akosblack/rs485rfid/README.md

# RS485-re alapuló RFID-s kártyaolvasó rendszer

Az Önálló laboratórium című tárgy keretein belül témának ezt válaszottam, mely során megismerkedtem az RS485-öt felépítő áramköri elemekkel, működésükkel. Arduino segítségével áramkört terveztem, annak működését teszteltem is. A projekt működéséhez szükséges két kódot ide feltöltve elhelyeztem.
A dokumentációhoz szükséges latex és forrásfájlait is megtalálható ezen repoban.

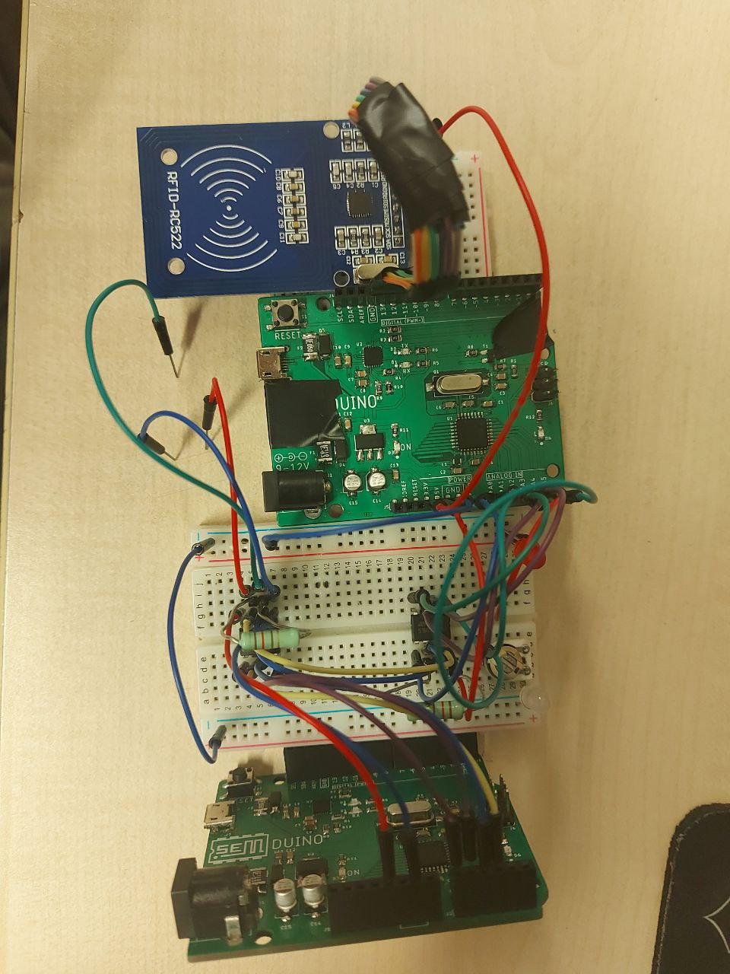
[picture p1: photo_2022-05-11_21-24-48.jpg]
Megvalósított kapcsolás élőben
