akosblack/rs485rfid/beszamolo/RS485-ös RFID kártyaolvasó rendszer.pptx

## RS485-ös RFID kártyaolvasó rendszer

Fekete Ákos

21/22 II.

Konzulens:
Dr. Fehér Gábor

## Cél: De mi is az a RS485?

RFID kártyaolvasó rendszer RS485-ön való kommunikációval, távolra

Egy elektronikai standard…
- röviden egy soros port, távolra
- hosszabban ->

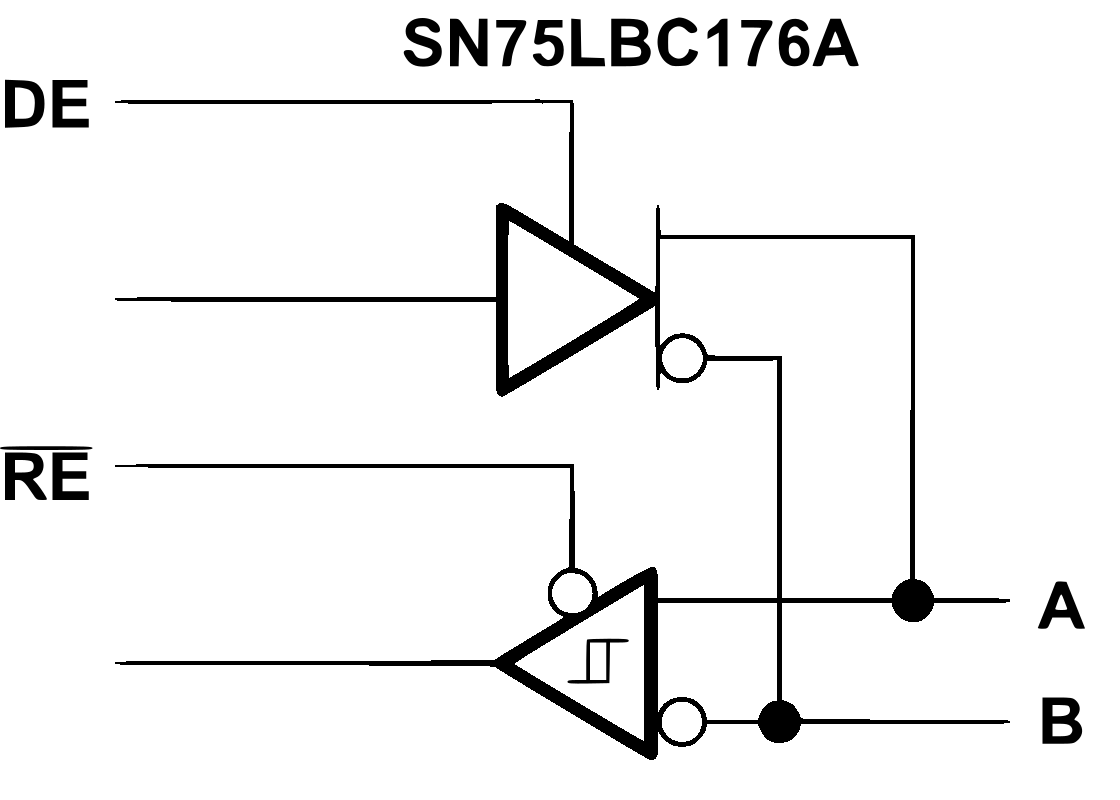
[picture p2: figure]

## Slide 3

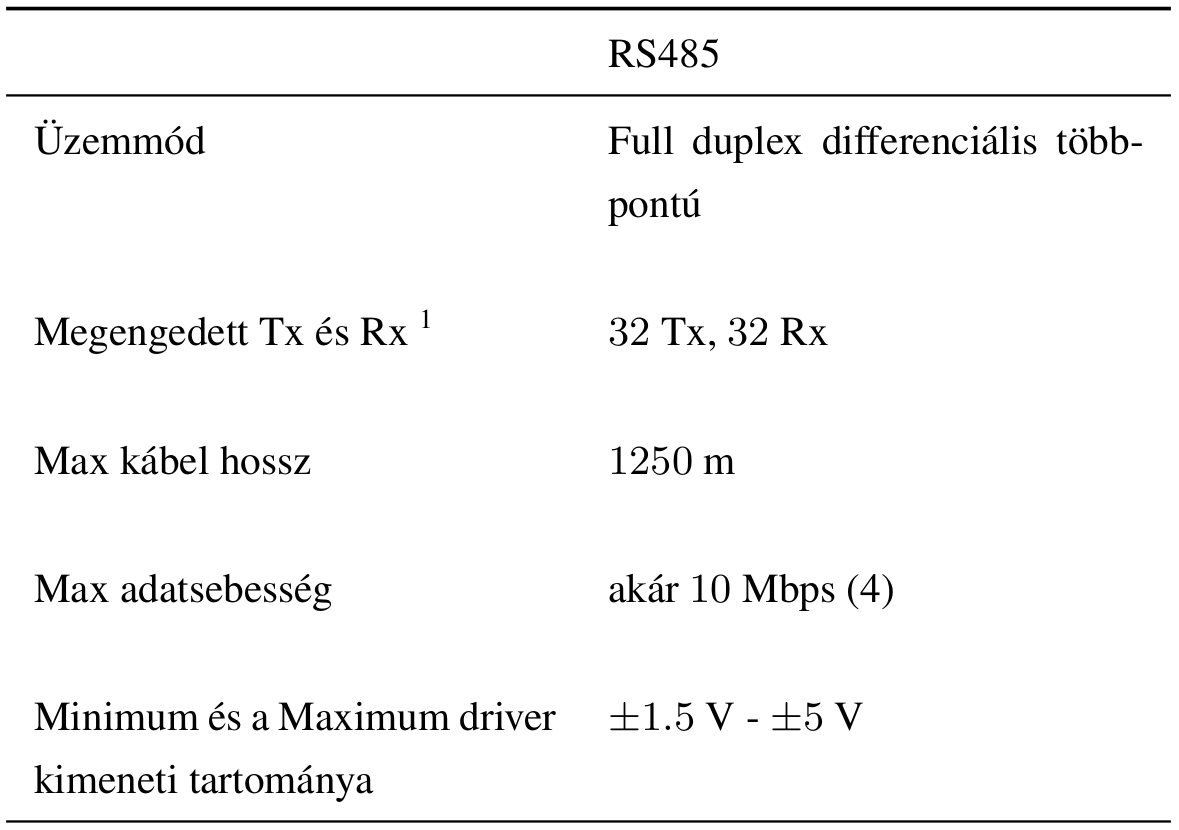
[picture p3: figure]

RS485 mint elektronikai standard:

Felhasznált IC:

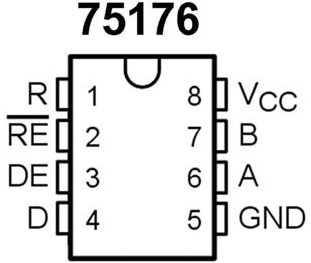
[picture p4: figure]

## Differenciális működés A és B között

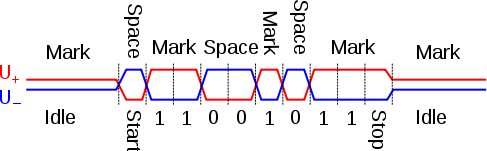
[picture p5: figure]

## A megvalósított kapcsolás

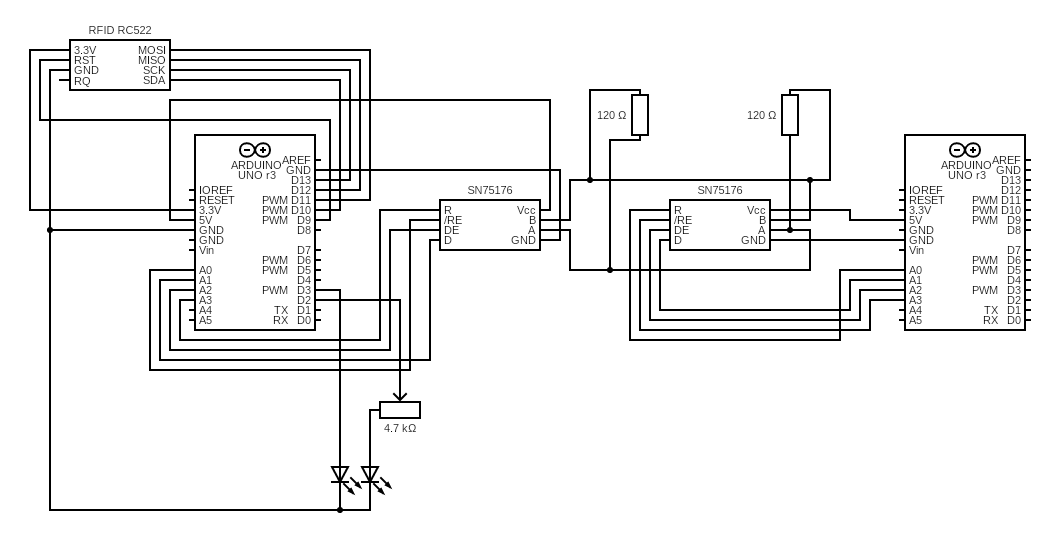
[picture p6: figure]

## Beolvasás és adatfolyam menete

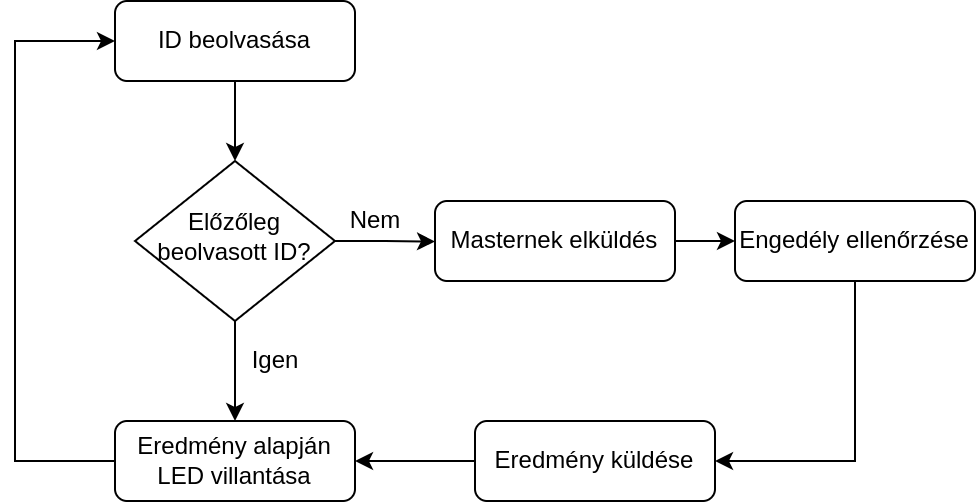
[picture p7: figure]

## A megvalósított adatfolyam A és B hullámformája

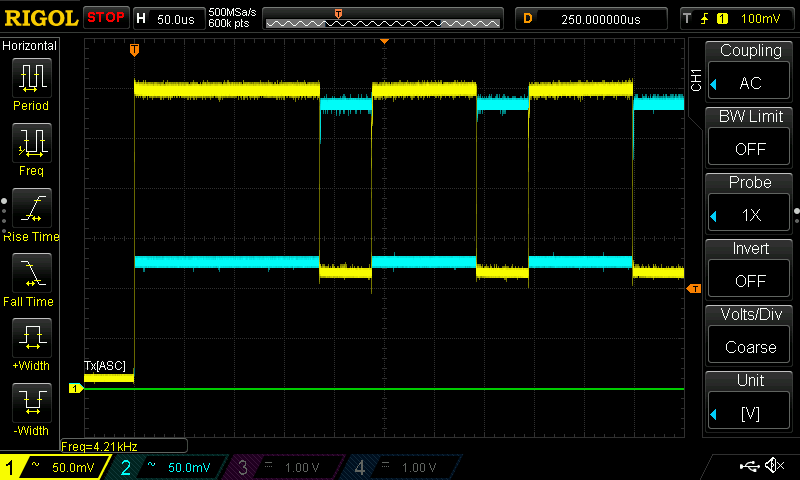
[picture p8: figure]

- Megfelel-e az elvárásoknak?
  - Meg, de így is alacsony a jelszint
- Ha nem, miért?
  - Tápellátás nem megfelelő

## 12V DC jelalakja

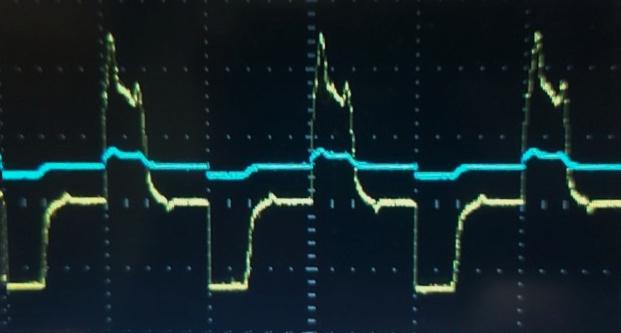
[picture p9: figure]

A felhasznált SEMDuino nem alkalmas 12V-ról való működéstetésre, az rajta lévő LDO nem bírja

## Merre tovább?

- Kijelző illesztése a terminálokhoz…
- Apróságok fejlesztése (címezhető LED, csipogó, jobb algoritmus)...
- Saját nyák tervezése…
- 3D nyomtatott ház
- Kamera modul + arcfelismerés…

## Kérdések

## Köszönöm a figyelmet!
