akosblack/rs485rfid/beszamolo/full_osc-eps-converted-to.pdf

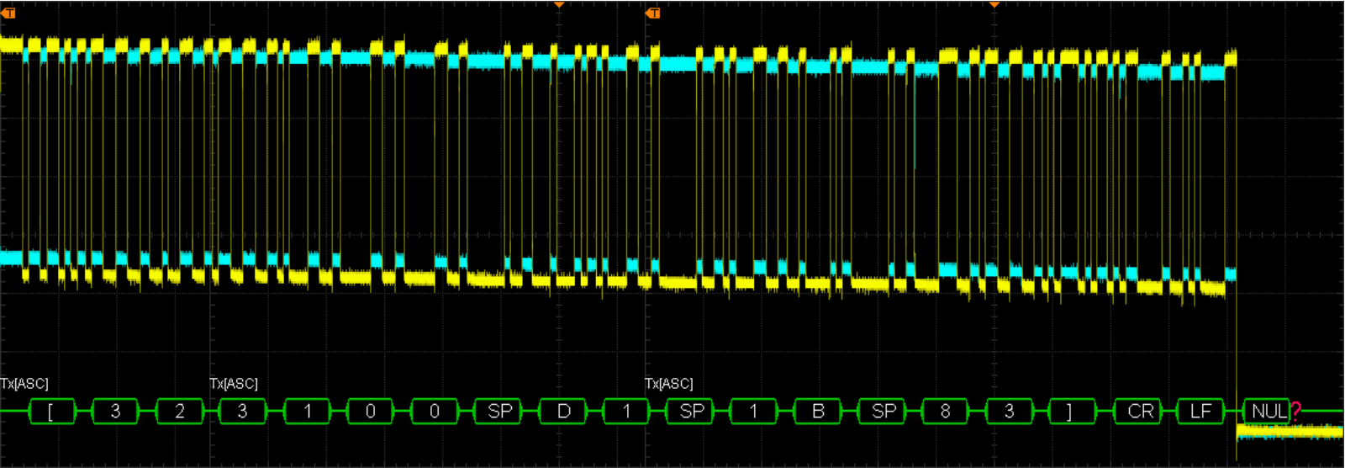
[picture p17: page 1]
