akosblack/rs485rfid/rs485_pcb/BOM_PCB_rs485 copper poured_2022-12-15.csv

ID | Name | Designator | Footprint | Quantity | Manufacturer Part | Manufacturer | Supplier | Supplier Part | Price | Pins | 3DModel | JLCPCB Part Class | Contributor | link
1 | JFC2410-0500FS | F1 | F2410 | 1 | JFC2410-0500FS | JDTfuse(集电通) | LCSC | C136360 | 0.012 | 2 | F2410_L6.2-W2.7-H2.7 | Extended Part | LCSC | https://item.szlcsc.com/349662.html
2 | TSD003B05518A | PROG,RST | SW-SMD_4P-L6.0-W6.0-P4.50-LS8.6 | 2 | TSD003B05518A | BZCN(博众电气) | LCSC | C2888768 | 0.003 | 4 | SW-SMD_4P-L6.0-W6.0-P4.50-LS8.6 | Extended Part | LCSC | https://item.szlcsc.com/2796384.html
3 | Header-Male-2.54_1x2 | H1 | HDR-TH_2P-P2.54-V-M-1 | 1 | 826629-2 | TE Connectivity(美国泰科) | LCSC | C86471 | 0.063 | 2 | HDR-M-2.54_1x2 | Extended Part | lcsc | https://item.szlcsc.com/366904.html
4 | AMS1117-3.3 | AMS1 | SOT-223-3_L6.5-W3.4-P2.30-LS7.0-BR | 1 | AMS1117-3.3 | AMS | LCSC | C6186 | 0.023 | 4 | SOT-223-4P_L6.5-W3.5-H1.6-LS7.0-P2.30 | Basic Part | lcsc | https://item.szlcsc.com/410724.html
5 | 1k | R2,R3 | R0603 | 2 |  |  |  |  |  | 2 | R0603_L1.6-W0.8-H0.8 |  | LCEDA_Lib | https://www.mouser.in/datasheet/2/447/PYu_RT_1_to_0_01_RoHS_L_11-1669912.pdf
6 | LED-0603_B | TX1,RX1 | LED0603_BLUE | 2 | 19-217/BHC-ZL1M2RY/3T | EVERLIGHT(台湾亿光) | LCSC | C72041 | 0.003 | 2 | LED0603_Blue |  | LCEDA_01
7 | SN75176BDR | RS485 | SOIC-8_L5.0-W4.0-P1.27-LS6.0-BL | 1 | SN75176BDR | TI | LCSC | C7063 | 0.047 | 8 | SOIC-8_L4.9-W3.9-H1.7-LS6.0-P1.27 | Basic Part | lcsc | https://item.szlcsc.com/417287.html
8 | 100uF | C4 | CAP-SMD_BD5.0-L5.3-W5.3-FD | 1 | RVT1A101M0505 | HONOR | LCSC | C3347 | 0.005 | 2 | CAP-SMD_L5.3-W5.3-H5.3-LS5.9 |  | 官方封装库 | https://item.szlcsc.com/245725.html
9 | USB3.1C16PFSMT | USBC1 | USB-C-SMD_TYPE-C-USB-17 | 1 | - | LCSC | LCSC | C167321 | 0.055 | 16 | USB-3.1-SMD_16P-L8.9-W7.3-H3.3-P0.5 | Extended Part | LCSC | https://item.szlcsc.com/178704.html
10 | CH340E | U1 | MSOP-10_L3.0-W3.0-P0.50-LS5.0-BL | 1 | CH340E | WCH | LCSC | C99652 | 0.085 | 10 | MSOP-10_L3.0-W3.0-H1.1-LS5.0-P0.50 | Extended Part | lcsc | https://item.szlcsc.com/221388.html
11 | 10k | R1 | R0603 | 1 |  |  |  |  |  | 2 | R0603_L1.6-W0.8-H0.8 |  | LCEDA_Lib | https://www.mouser.in/datasheet/2/447/PYu_RT_1_to_0_01_RoHS_L_11-1669912.pdf
12 | 10u | C1,C2 | C0603 | 2 |  |  |  |  |  | 2 | C0603_L1.6-W0.8-H0.8 |  | LCEDA_Lib | https://item.szlcsc.com/362304.html
13 | ESP-12F(ESP8266MOD) | U2 | WIFIM-SMD_ESP-12F-ESP8266MOD | 1 | ESP-12F(ESP8266MOD) | Ai-Thinker | LCSC | C82891 | 0.339 | 22 | WIFIM-SMD_WIFI-L24.0-W16.0-H3.1 | Extended Part | 立创EDA官方封装库 | https://item.szlcsc.com/84052.html
14 | TPCDSOT23-SM712 | D1 | SOT-23-3_L2.9-W1.6-P1.90-LS2.8-BR | 1 | TPCDSOT23-SM712 | TECH PUBLIC | LCSC | C558433 | 0.014 | 3 | SOT-23-3L_L2.9-W1.6-H1.1-LS2.8-P0.95 | Extended Part | LCSC | https://item.szlcsc.com/14454.html
15 | USBLC6-2SC6_C2827654 | D2 | SOT-23-6_L2.9-W1.6-P0.95-LS2.8-BL | 1 | USBLC6-2SC6 | TECH PUBLIC(台舟) | LCSC | C2827654 | 0.011 | 6 | SOT-23-6_L2.9-W1.6-H1.5-LS2.8-P0.95 | Extended Part | LCSC | https://item.szlcsc.com/169042.html
16 | Header-Female-2.54_1x8 | RFID | HDR-TH_8P-P2.54-V-F-1 | 1 | Female headerHDR1X8-2.54 | BOOMELE | LCSC | C27438 | 0.012 | 8 | HDR-F-2.54_1x8 | Extended Part | 官方封装库 | https://item.szlcsc.com/290266.html
17 | Header-Male-2.54_2x4 | P2 | HDR-TH_8P-P2.54-V-M-R2-C4-S2.54 | 1 | Header2X4P 2.54mm | ReliaPro | LCSC | C58363 |  | 8 | HDR-TH_8P-P2.54-M-LI-2X4P | Extended Part | lcsc | https://item.szlcsc.com/502977.html
18 | WS2812E-V5 | LED1 | LED-SMD_4P-L5.0-W5.0-LS5.4-TL-1 | 1 | WS2812E-V5 | worldsemi | LCSC | C2920042 | 0.013 | 4 | LED-SMD_4P-L5.0-W5.0-LS5.4-TL-1 | Extended Part | lcsc | https://img.jlc.com/pdf/applyPasteComponent/2022-03-02/714375A/dfc24d31841c42bc8cca891b5175562b/TX1812CXA-5050%E5%86%85%E7%BD%AEIC%E8%A7%84%E6%A0%BC%E4%B9%A6.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
19 | 1u | C5,C6 | C0603 | 2 |  |  |  |  |  | 2 | C0603_L1.6-W0.8-H0.8 |  | LCEDA_Lib | https://item.szlcsc.com/362304.html
20 | 0.1u | C7,C8 | C0603 | 2 |  |  |  |  |  | 2 | C0603_L1.6-W0.8-H0.8 |  | LCEDA_Lib | https://item.szlcsc.com/362304.html
21 | 120 | R4 | R0603 | 1 |  |  |  |  |  | 2 | R0603_L1.6-W0.8-H0.8 |  | LCEDA_Lib | https://www.mouser.in/datasheet/2/447/PYu_RT_1_to_0_01_RoHS_L_11-1669912.pdf
22 | 330 | R5 | R0603 | 1 |  |  |  |  |  | 2 | R0603_L1.6-W0.8-H0.8 |  | LCEDA_Lib | https://www.mouser.in/datasheet/2/447/PYu_RT_1_to_0_01_RoHS_L_11-1669912.pdf
23 | 100uF | C3 | C1206 | 1 |  |  |  |  |  | 2 | C1206_L3.2-W1.6-H1.3 |  | LCEDA_Lib | https://item.szlcsc.com/89171.html
