akosblack/rs485rfid/beszamolo/flowchart-eps-converted-to.pdf

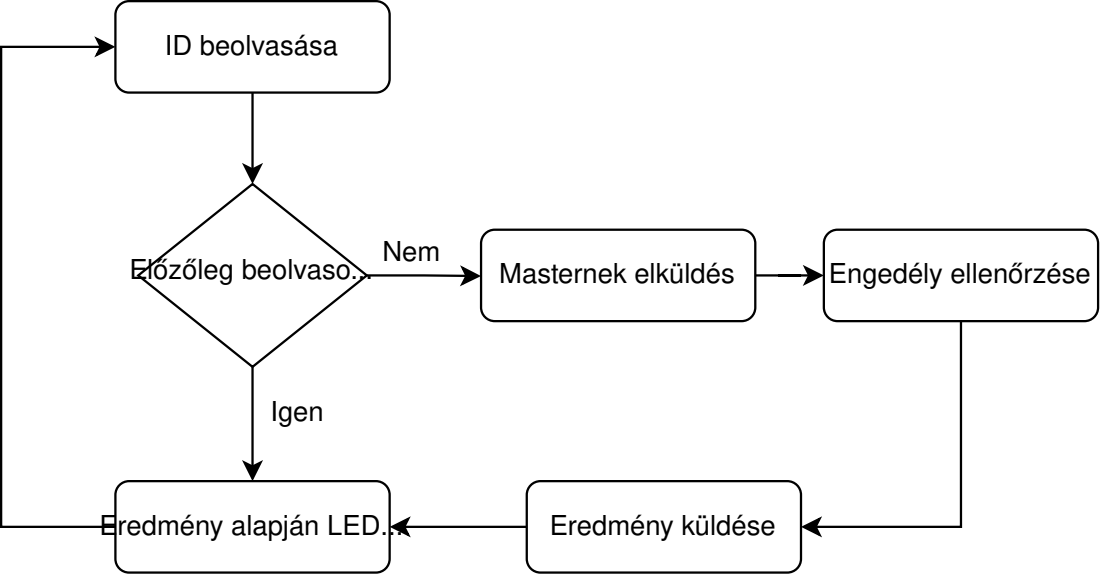
[picture p18: page 1]
ID beolvasása; Eredmény küldése; Előzőleg beolvaso...; Igen; Nem; Masternek elküldés; Engedély ellenőrzése

Eredmény alapján LED...
