akosblack/rs485rfid/beszamolo/circuit-eps-converted-to.pdf

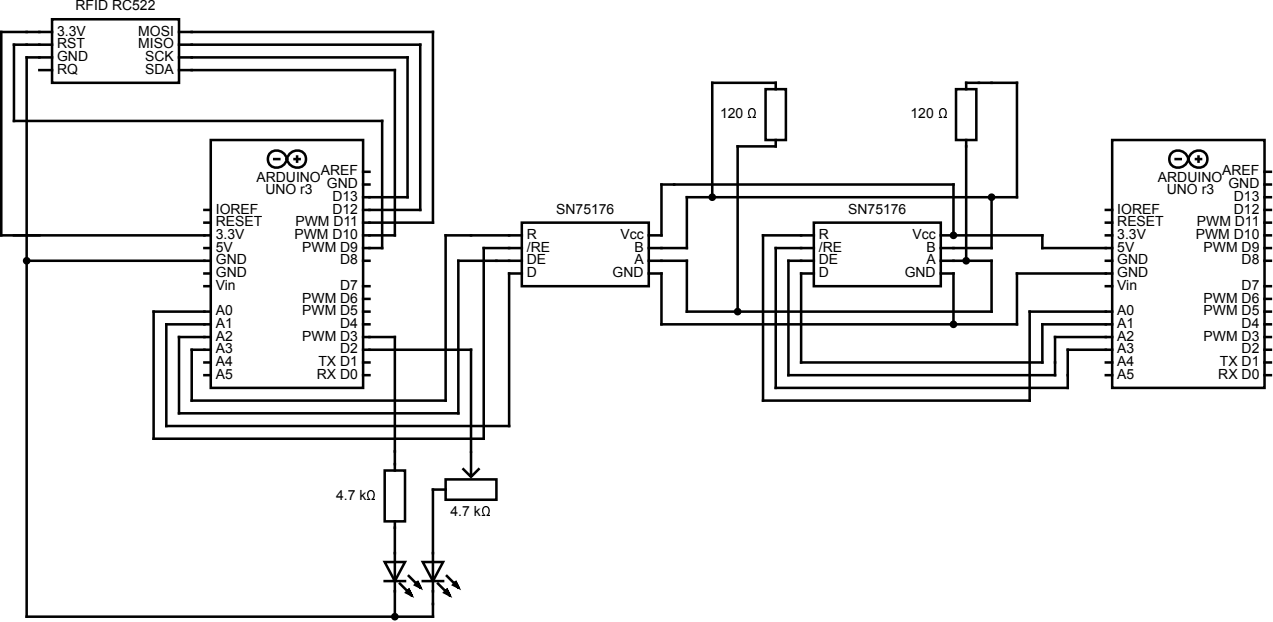
[picture p19: page 1]
