akosblack/rs485rfid/(list of files, drawings)

Other design files:
projects/offline_projects_backup/rs485/20221123_180113/PCB_rs485.json
projects/offline_projects_backup/rs485/20221123_183952/PCB_rs485.json
projects/offline_projects_backup/rs485/20221123_193919/PCB_rs485.json
projects/offline_projects_backup/rs485/20221123_200352/PCB_rs485.json
projects/projects/rs485/PCB_rs485.json
rs485_pcb/PCB_rs485 copper poured.json
