akosblack/rs485rfid/(commit log)

2022-11-23 pcb design
    [PCB_rs485.json]
2022-12-19 PCB done
    - PCB done and added dipterv sablon to to project
    [BOM_PCB_rs485 copper poured_2022-12-15.csv, PCB_rs485 copper poured.json, PCB_rs485.json, PickAndPlace_PCB_rs485 copper poured_2022-12-15.csv]
